chill389cc/Soundboard/README.md

# Soundboard
Code and schematics for a macropad soundboard system for the office bullpen
