chill389cc/Soundboard/CAD/Soundboard/Soundboard.kicad_pcb

## KiCad design CAD/Soundboard/Soundboard.kicad_pcb (2025-11-08)

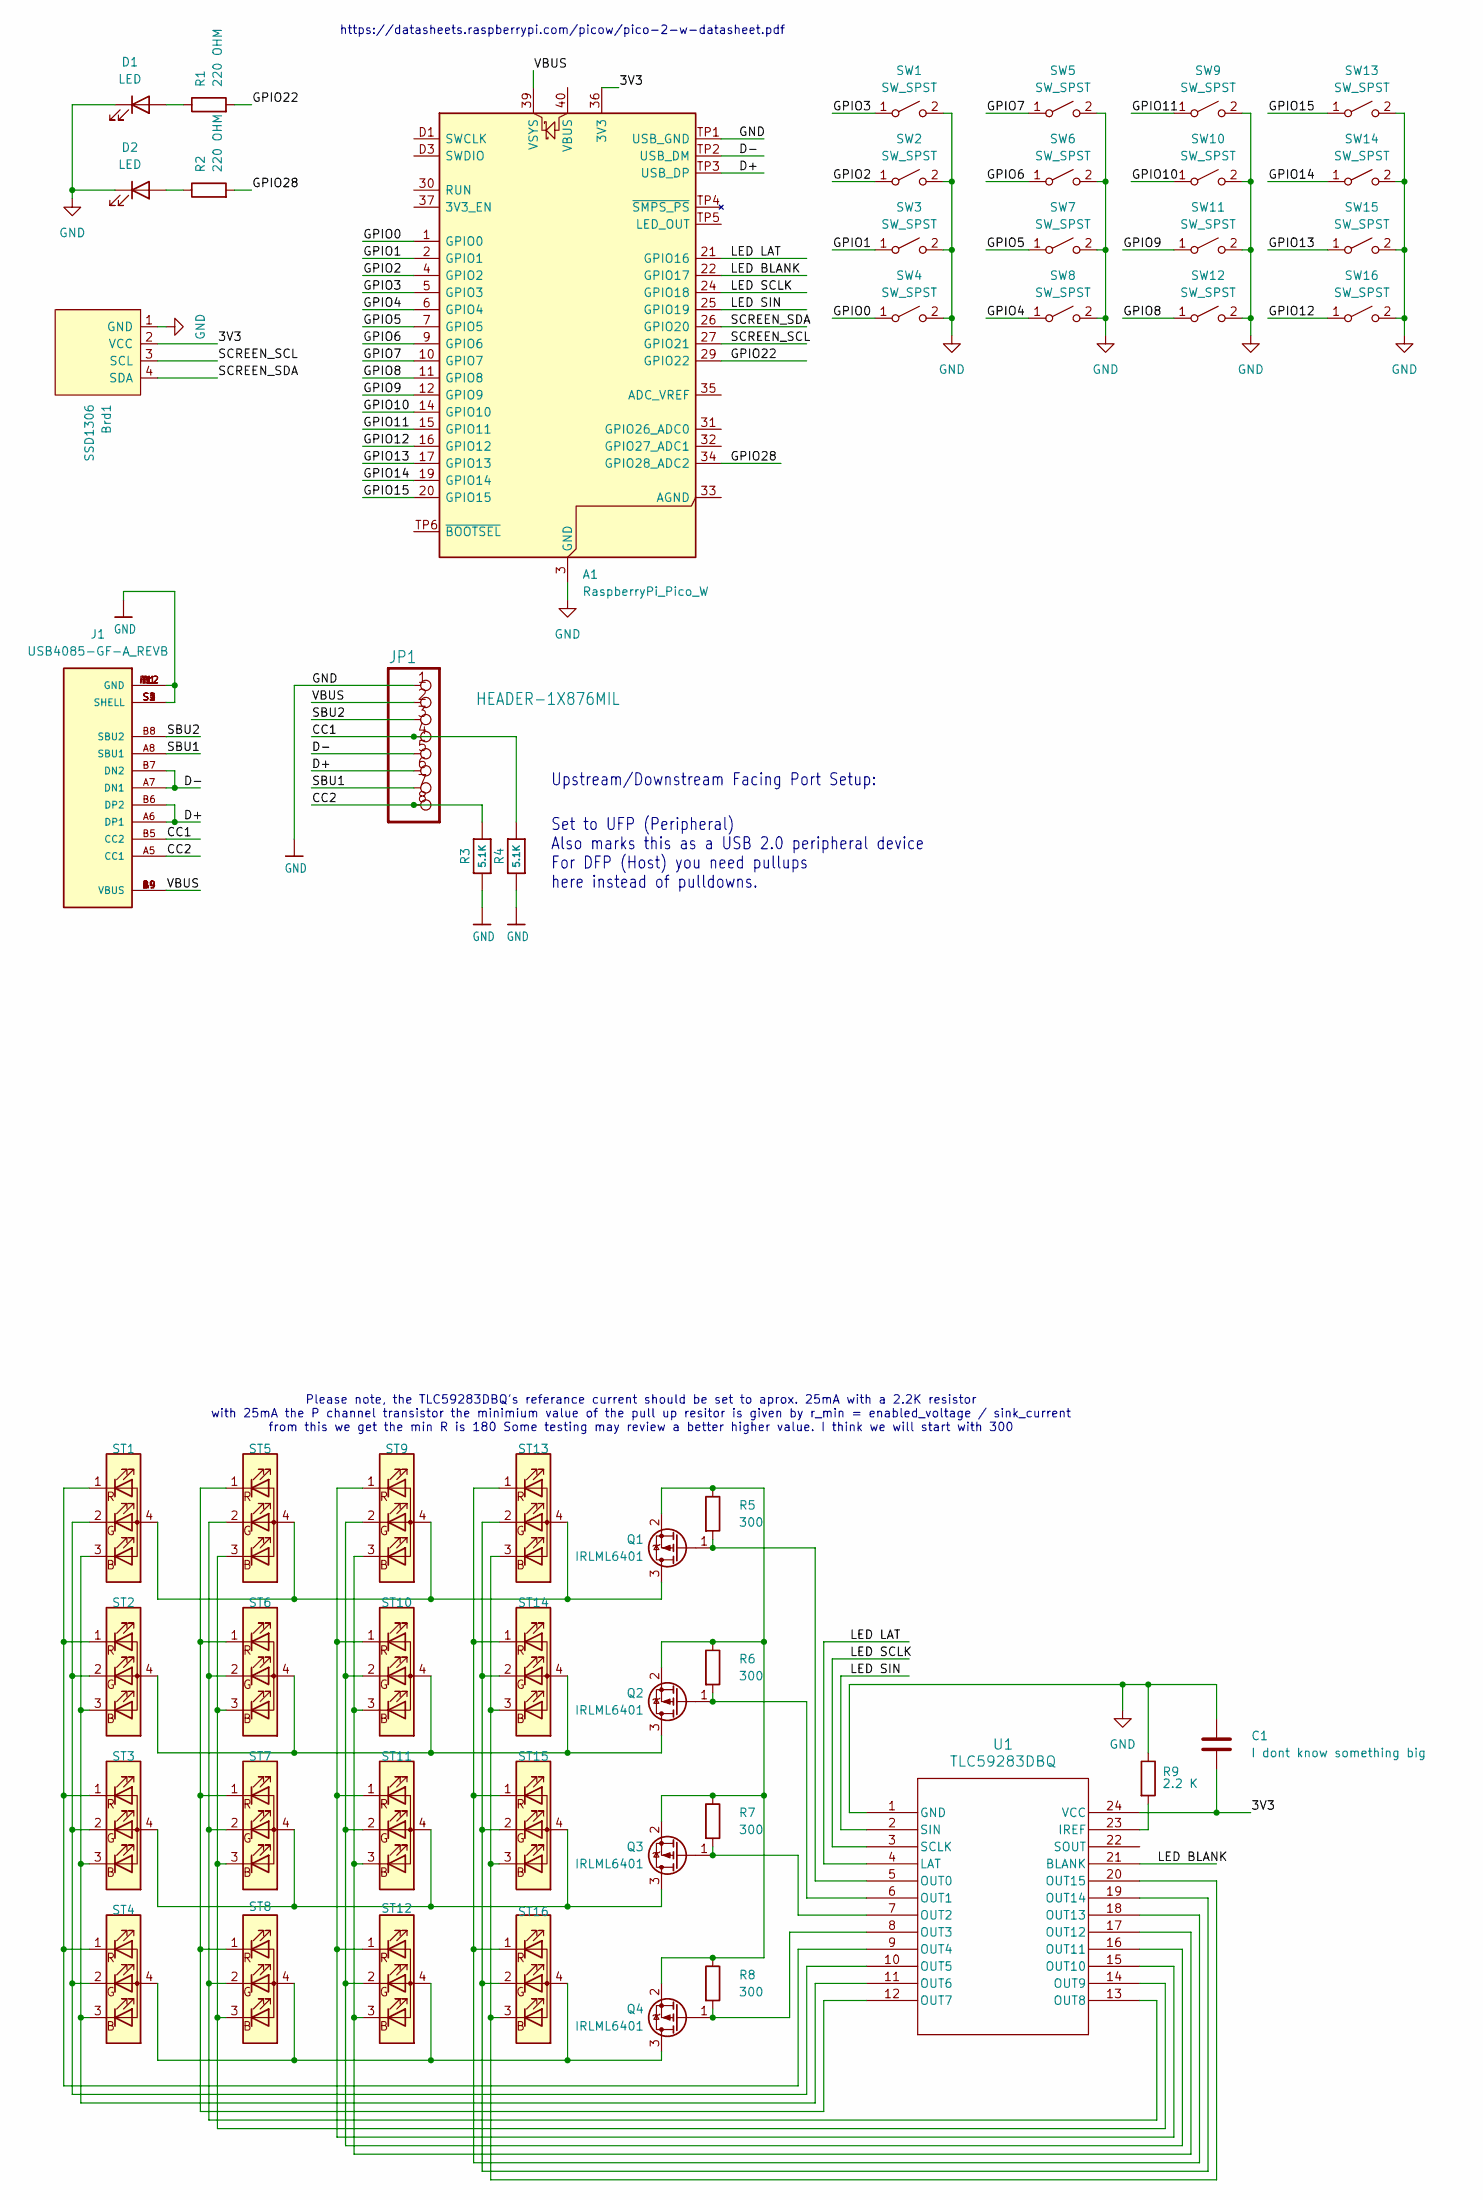
[picture p1: schematic Soundboard.kicad_sch]

Parts:
A1: RaspberryPi_Pico_W; RaspberryPi_Pico_W_SMD
Brd1: SSD1306; Adafruit_SSD1306
C1: I dont know something big; C_0805_2012Metric
D1, D2: LED; LED_D5.0mm_Clear
J1: USB4085-GF-A_REVB; GCT_USB4085-GF-A_REVB; PARTREV B
JP1: HEADER-1X876MIL; PinHeader_1x08_P2.54mm_Vertical
Q1, Q2, Q3, Q4: IRLML6401; SOT-23
R1, R2: 220 OHM; R_Axial_DIN0204_L3.6mm_D1.6mm_P7.62mm_Horizontal
R3, R4: 5.1K; R_0805_2012Metric
R5, R6, R7, R8: 300; R_0805_2012Metric
R9: 2.2 K; R_0805_2012Metric
ST1, ST2, ST3, ST4, ST5, ST6, ST7, ST8, ST9, ST10, ST11, ST12, ST13, ST14, ST15, ST16: ASMB-MTB1-0A3A2; LED_Avago_PLCC4_3.2x2.8mm_CW
SW1, SW2, SW3, SW4, SW5, SW6, SW7, SW8, SW9, SW10, SW11, SW12, SW13, SW14, SW15, SW16: SW_SPST; SW_Cherry_MX_PCB_1.00u
U1: TLC59283DBQ; DBQ24_TEX

Connections:
/3V3: A1.36 (3V3), Brd1.2 (VCC), C1.2, U1.24 (VCC)
/CC1: J1.B5 (CC2), JP1.4, R4.2
/CC2: J1.A5 (CC1), JP1.8, R3.2
/D+: A1.TP3 (USB_DP), J1.A6 (DP1), J1.B6 (DP2), JP1.6
/D-: A1.TP2 (USB_DM), J1.A7 (DN1), J1.B7 (DN2), JP1.5
/GPIO0: A1.1 (GPIO0), SW4.1 (A)
/GPIO1: A1.2 (GPIO1), SW3.1 (A)
/GPIO2: A1.4 (GPIO2), SW2.1 (A)
/GPIO3: A1.5 (GPIO3), SW1.1 (A)
/GPIO4: A1.6 (GPIO4), SW8.1 (A)
/GPIO5: A1.7 (GPIO5), SW7.1 (A)
/GPIO6: A1.9 (GPIO6), SW6.1 (A)
/GPIO7: A1.10 (GPIO7), SW5.1 (A)
/GPIO8: A1.11 (GPIO8), SW12.1 (A)
/GPIO9: A1.12 (GPIO9), SW11.1 (A)
/GPIO10: A1.14 (GPIO10), SW10.1 (A)
/GPIO11: A1.15 (GPIO11), SW9.1 (A)
/GPIO12: A1.16 (GPIO12), SW16.1 (A)
/GPIO13: A1.17 (GPIO13), SW15.1 (A)
/GPIO14: A1.19 (GPIO14), SW14.1 (A)
/GPIO15: A1.20 (GPIO15), SW13.1 (A)
/GPIO22: A1.29 (GPIO22), R1.2
/GPIO28: A1.34 (GPIO28_ADC2), R2.2
/LED BLANK: A1.22 (GPIO17), U1.21 (BLANK)
/LED LAT: A1.21 (GPIO16), U1.4 (LAT)
/LED SCLK: A1.24 (GPIO18), U1.3 (SCLK)
/LED SIN: A1.25 (GPIO19), U1.2 (SIN)
/SBU1: J1.A8 (SBU1), JP1.7
/SBU2: J1.B8 (SBU2), JP1.3
/SCREEN_SCL: A1.27 (GPIO21), Brd1.3 (SCL)
/SCREEN_SDA: A1.26 (GPIO20), Brd1.4 (SDA)
/VBUS: A1.39 (VSYS), J1.A4 (VBUS), J1.A9 (VBUS), J1.B4 (VBUS), J1.B9 (VBUS), JP1.2
GND: A1.3 (GND), A1.8 (GND), A1.13 (GND), A1.18 (GND), A1.23 (GND), A1.28 (GND), A1.38 (GND), A1.D2 (GND), A1.TP1 (USB_GND), Brd1.1 (GND), C1.1, D1.1 (K), D2.1 (K), J1.A1 (GND), J1.A12 (GND), J1.B1 (GND), J1.B12 (GND), J1.S1 (SHELL), J1.S2 (SHELL), J1.S3 (SHELL), J1.S4 (SHELL), JP1.1, R3.1, R4.1, R9.1, SW1.2 (B), SW2.2 (B), SW3.2 (B), SW4.2 (B), SW5.2 (B), SW6.2 (B), SW7.2 (B), SW8.2 (B), SW9.2 (B), SW10.2 (B), SW11.2 (B), SW12.2 (B), SW13.2 (B), SW14.2 (B), SW15.2 (B), SW16.2 (B), U1.1 (GND)
unnamed: D1.2 (A), R1.1
unnamed: D2.2 (A), R2.1
unnamed: Q1.3 (D), ST1.4 (A), ST5.4 (A), ST9.4 (A), ST13.4 (A)
unnamed: Q1.1 (G), R5.2, U1.5 (OUT0)
unnamed: Q1.2 (S), Q2.2 (S), Q3.2 (S), Q4.2 (S), R5.1, R6.1, R7.1, R8.1
unnamed: Q2.3 (D), ST2.4 (A), ST6.4 (A), ST10.4 (A), ST14.4 (A)
unnamed: Q2.1 (G), R6.2, U1.6 (OUT1)
unnamed: Q3.3 (D), ST3.4 (A), ST7.4 (A), ST11.4 (A), ST15.4 (A)
unnamed: Q3.1 (G), R7.2, U1.7 (OUT2)
unnamed: Q4.3 (D), ST4.4 (A), ST8.4 (A), ST12.4 (A), ST16.4 (A)
unnamed: Q4.1 (G), R8.2, U1.8 (OUT3)
unnamed: ST1.3 (BK), ST2.3 (BK), ST3.3 (BK), ST4.3 (BK), U1.11 (OUT6)
unnamed: ST1.2 (GK), ST2.2 (GK), ST3.2 (GK), ST4.2 (GK), U1.10 (OUT5)
unnamed: ST1.1 (RK), ST2.1 (RK), ST3.1 (RK), ST4.1 (RK), U1.9 (OUT4)
unnamed: ST5.3 (BK), ST6.3 (BK), ST7.3 (BK), ST8.3 (BK), U1.14 (OUT9)
unnamed: ST5.2 (GK), ST6.2 (GK), ST7.2 (GK), ST8.2 (GK), U1.13 (OUT8)
unnamed: ST5.1 (RK), ST6.1 (RK), ST7.1 (RK), ST8.1 (RK), U1.12 (OUT7)
unnamed: ST9.3 (BK), ST10.3 (BK), ST11.3 (BK), ST12.3 (BK), U1.17 (OUT12)
unnamed: ST9.2 (GK), ST10.2 (GK), ST11.2 (GK), ST12.2 (GK), U1.16 (OUT11)
unnamed: ST9.1 (RK), ST10.1 (RK), ST11.1 (RK), ST12.1 (RK), U1.15 (OUT10)
unnamed: ST13.3 (BK), ST14.3 (BK), ST15.3 (BK), ST16.3 (BK), U1.20 (OUT15)
unnamed: ST13.2 (GK), ST14.2 (GK), ST15.2 (GK), ST16.2 (GK), U1.19 (OUT14)
unnamed: ST13.1 (RK), ST14.1 (RK), ST15.1 (RK), ST16.1 (RK), U1.18 (OUT13)
unnamed: R9.2, U1.23 (IREF)

Notes on the sheet:
https://datasheets.raspberrypi.com/picow/pico-2-w-datasheet.pdf
Upstream/Downstream Facing Port Setup:
Please note, the TLC59283DBQ's referance current should be set to aprox. 25mA with a 2.2K resistor with 25mA the P channel transistor the minimium value of the pull up resitor is given by r_min = enabled_voltage / sink_current from this we get the min R is 180 Some testing may review a better highe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
Set to UFP (Peripheral) Also marks this as a USB 2.0 peripheral device For DFP (Host) you need pullups here instead of pulldowns.

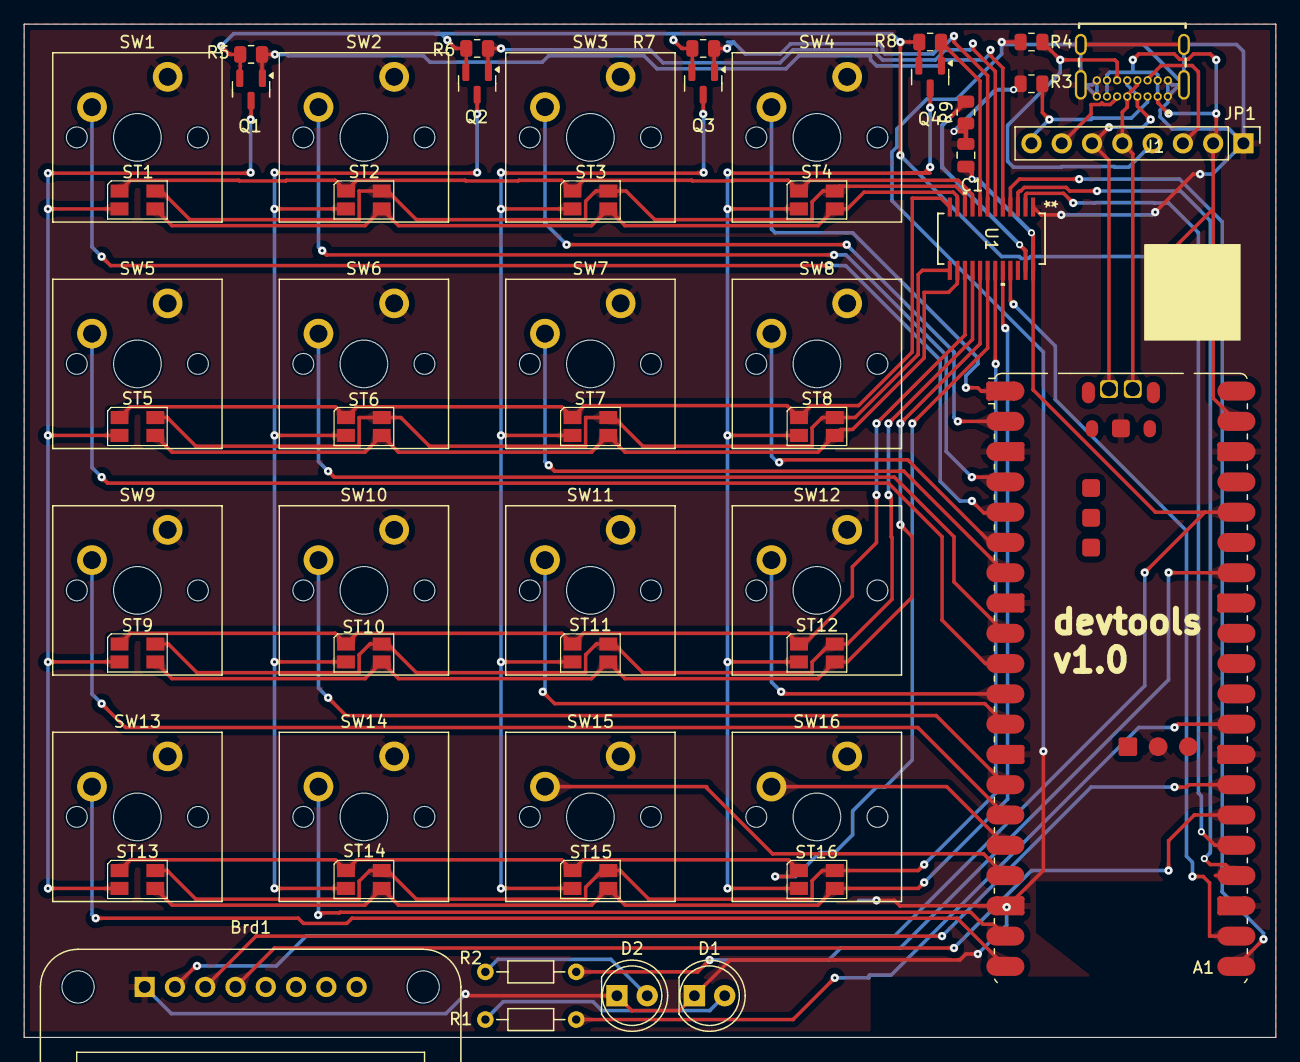
[picture p2: board Soundboard.kicad_pcb from above]

Board: 2 copper layers, 105.0 x 85.0 mm, 53 parts (0 on the bottom side), 57 nets.
