chill389cc/Soundboard/(commit log)

2025-04-26 initial schematic
    [Soundboard.kicad_pcb, Soundboard.kicad_sch]
2025-04-26 add sample python scripts
2025-05-20 add a bunch of submodule repos, add some fancy plexing circuits place and route
    [Soundboard.kicad_pcb, Soundboard.kicad_sch]
2025-09-11 swap led sclk and sin
    [Soundboard.kicad_pcb, Soundboard.kicad_sch]
2025-10-21 move some caps
    [Soundboard.kicad_pcb, Soundboard.kicad_sch]
